hordri/Wemos_ora/README.md

# Wemos_ora
Nixie clock with Wemos d1 mini and integrated switchmode supply
