hordri/Wemos_ora/PCB/wemos_ora/wemos_ora.brd

## EAGLE design PCB/wemos_ora/wemos_ora.brd (2019-09-20)

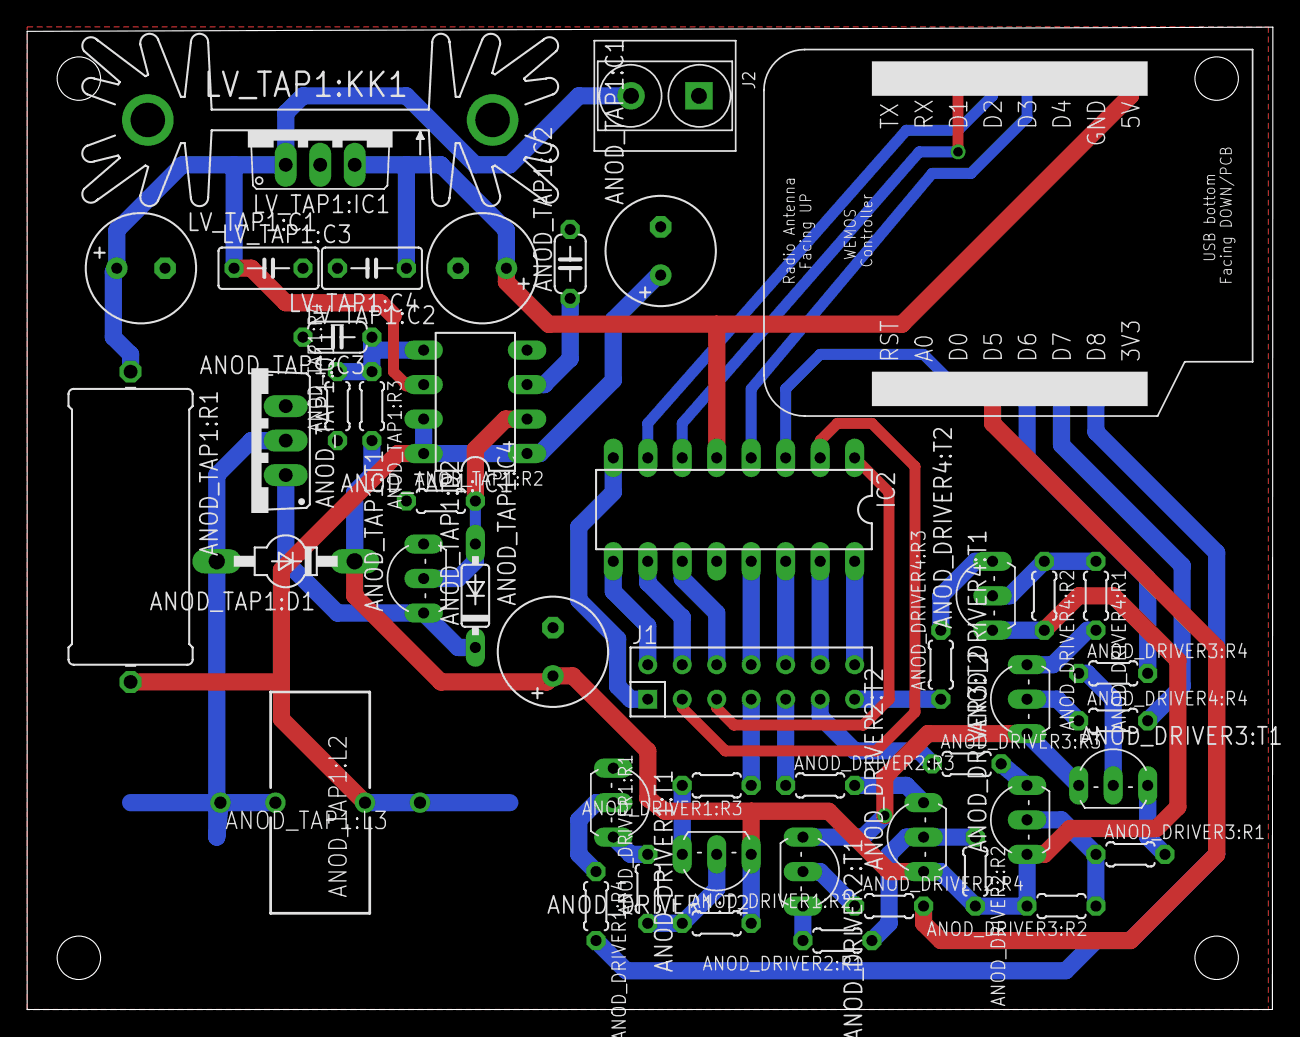
[picture p1: board wemos_ora.brd from above]

Board: 2 copper layers, 91.8 x 72.4 mm, 50 parts (1 on the bottom side), 48 nets.

Parts:
ANOD_DRIVER1:R1, ANOD_DRIVER2:R1, ANOD_DRIVER3:R1, ANOD_DRIVER4:R1: 470k; 0204/5
ANOD_DRIVER1:R2, ANOD_DRIVER2:R2, ANOD_DRIVER3:R2, ANOD_DRIVER4:R2: 100k; 0204/5
ANOD_DRIVER1:R3, ANOD_DRIVER2:R3, ANOD_DRIVER3:R3, ANOD_DRIVER4:R3: 15k; 0204/5
ANOD_DRIVER1:R4, ANOD_DRIVER2:R4, ANOD_DRIVER3:R4, ANOD_DRIVER4:R4: 22k; 0204/5
ANOD_DRIVER1:T1, ANOD_DRIVER2:T1, ANOD_DRIVER3:T1, ANOD_DRIVER4:T1: MPSA42; TO92-EBC
ANOD_DRIVER1:T2, ANOD_DRIVER2:T2, ANOD_DRIVER3:T2, ANOD_DRIVER4:T2: MPSA92; TO92-EBC
ANOD_TAP1:C1: 220u; E3,5-8
ANOD_TAP1:C2: 2n2; C050-024X044
ANOD_TAP1:C3: 10n; C050-024X044
ANOD_TAP1:C4: 2u2; E3,5-8
ANOD_TAP1:D1: BYV27; SOD57-10
ANOD_TAP1:D2: 1N4148DO35-7; DO35-7
ANOD_TAP1:IC1: MC34063AP; DIL08
ANOD_TAP1:L1: PM2120
ANOD_TAP1:L2: TJ3-U1
ANOD_TAP1:L3: TJ3-U2
ANOD_TAP1:Q1: IRF740; TO220BV
ANOD_TAP1:R1: 0R47; 0922/22
ANOD_TAP1:R2: 1k; 0204/5
ANOD_TAP1:R3: 470k; 0204/5
ANOD_TAP1:R4: 3k3; 0204/5
ANOD_TAP1:T1: MPSA92; TO92-EBC
IC2: 74141N; DIL16
J1: CON_HEADER_2X07-PTH; M2X7
J2: 2p-5.08; H2-5.0-10.5X8.0MM
LV_TAP1:C1, LV_TAP1:C2: 470u; E3,5-8
LV_TAP1:C3, LV_TAP1:C4: 100n; C050-030X075
LV_TAP1:IC1: 7805TV; TO220V
LV_TAP1:KK1: SK104-PAD
U$1: WEMOS

Connections:
+5V: IC2.5, LV_TAP1:C2.+, LV_TAP1:C4.1, LV_TAP1:IC1.3, U$1.5V
+9V: ANOD_TAP1:IC1.6, ANOD_TAP1:R1.1, J2.2, LV_TAP1:C1.+, LV_TAP1:C3.1, LV_TAP1:IC1.1
+24V: ANOD_DRIVER1:R2.2, ANOD_DRIVER1:T2.E, ANOD_DRIVER2:R2.2, ANOD_DRIVER2:T2.E, ANOD_DRIVER3:R2.2, ANOD_DRIVER3:T2.E, ANOD_DRIVER4:R2.2, ANOD_DRIVER4:T2.E, ANOD_TAP1:C4.+, ANOD_TAP1:D1.C, ANOD_TAP1:R3.2
ANOD_DRIVER1:N$1: ANOD_DRIVER1:R3.2, ANOD_DRIVER1:T2.C
ANOD_DRIVER1:N$2: ANOD_DRIVER1:R1.1, ANOD_DRIVER1:R2.1, ANOD_DRIVER1:T2.B
ANOD_DRIVER1:N$3: ANOD_DRIVER1:R1.2, ANOD_DRIVER1:T1.C
ANOD_DRIVER1:N$4: ANOD_DRIVER1:R4.1, ANOD_DRIVER1:T1.B
ANOD_DRIVER2:N$1: ANOD_DRIVER2:R3.2, ANOD_DRIVER2:T2.C
ANOD_DRIVER2:N$2: ANOD_DRIVER2:R1.1, ANOD_DRIVER2:R2.1, ANOD_DRIVER2:T2.B
ANOD_DRIVER2:N$3: ANOD_DRIVER2:R1.2, ANOD_DRIVER2:T1.C
ANOD_DRIVER2:N$4: ANOD_DRIVER2:R4.1, ANOD_DRIVER2:T1.B
ANOD_DRIVER3:N$1: ANOD_DRIVER3:R3.2, ANOD_DRIVER3:T2.C
ANOD_DRIVER3:N$2: ANOD_DRIVER3:R1.1, ANOD_DRIVER3:R2.1, ANOD_DRIVER3:T2.B
ANOD_DRIVER3:N$3: ANOD_DRIVER3:R1.2, ANOD_DRIVER3:T1.C
ANOD_DRIVER3:N$4: ANOD_DRIVER3:R4.1, ANOD_DRIVER3:T1.B
ANOD_DRIVER4:N$1: ANOD_DRIVER4:R3.2, ANOD_DRIVER4:T2.C
ANOD_DRIVER4:N$2: ANOD_DRIVER4:R1.1, ANOD_DRIVER4:R2.1, ANOD_DRIVER4:T2.B
ANOD_DRIVER4:N$3: ANOD_DRIVER4:R1.2, ANOD_DRIVER4:T1.C
ANOD_DRIVER4:N$4: ANOD_DRIVER4:R4.1, ANOD_DRIVER4:T1.B
ANOD_TAP1:N$1: ANOD_TAP1:C1.+, ANOD_TAP1:IC1.1, ANOD_TAP1:IC1.7, ANOD_TAP1:IC1.8, ANOD_TAP1:L1.1, ANOD_TAP1:L2.1, ANOD_TAP1:L3.1, ANOD_TAP1:R1.2
ANOD_TAP1:N$3: ANOD_TAP1:D1.A, ANOD_TAP1:L1.2, ANOD_TAP1:L2.2, ANOD_TAP1:L3.2, ANOD_TAP1:Q1.D
ANOD_TAP1:N$4: ANOD_TAP1:D2.A, ANOD_TAP1:IC1.2, ANOD_TAP1:R2.2, ANOD_TAP1:T1.B
ANOD_TAP1:N$5: ANOD_TAP1:D2.C, ANOD_TAP1:Q1.G, ANOD_TAP1:T1.E
ANOD_TAP1:N$8: ANOD_TAP1:C2.1, ANOD_TAP1:IC1.3
ANOD_TAP1:N$14: ANOD_TAP1:C3.1, ANOD_TAP1:IC1.5, ANOD_TAP1:R3.1, ANOD_TAP1:R4.2
GND: ANOD_DRIVER1:T1.E, ANOD_DRIVER2:T1.E, ANOD_DRIVER3:T1.E, ANOD_DRIVER4:T1.E, ANOD_TAP1:C1.-, ANOD_TAP1:C2.2, ANOD_TAP1:C3.2, ANOD_TAP1:C4.-, ANOD_TAP1:IC1.4, ANOD_TAP1:Q1.S, ANOD_TAP1:R2.1, ANOD_TAP1:R4.1, ANOD_TAP1:T1.C, IC2.12, J2.1, LV_TAP1:C1.-, LV_TAP1:C2.-, LV_TAP1:C3.2, LV_TAP1:C4.2, LV_TAP1:IC1.2, U$1.GND
unnamed: IC2.16, J1.14
unnamed: IC2.15, J1.12
unnamed: IC2.8, J1.1
unnamed: IC2.9, J1.2
unnamed: IC2.13, J1.8
unnamed: IC2.14, J1.10
unnamed: IC2.11, J1.6
unnamed: IC2.10, J1.4
unnamed: IC2.1, J1.5
unnamed: IC2.2, J1.3
unnamed: ANOD_DRIVER1:R3.1, J1.7
unnamed: ANOD_DRIVER2:R3.1, J1.9
unnamed: ANOD_DRIVER3:R3.1, J1.11
unnamed: ANOD_DRIVER4:R3.1, J1.13
unnamed: IC2.3, U$1.D0
unnamed: IC2.6, U$1.D1
unnamed: IC2.7, U$1.D2
unnamed: IC2.4, U$1.D3
unnamed: ANOD_DRIVER1:R4.2, U$1.D8
unnamed: ANOD_DRIVER2:R4.2, U$1.D5
unnamed: ANOD_DRIVER3:R4.2, U$1.D6
unnamed: ANOD_DRIVER4:R4.2, U$1.D7
