hordri/Wemos_ora/PCB/wemos_ora/anod_tap.brd

## EAGLE design PCB/wemos_ora/anod_tap.brd (2019-09-18)

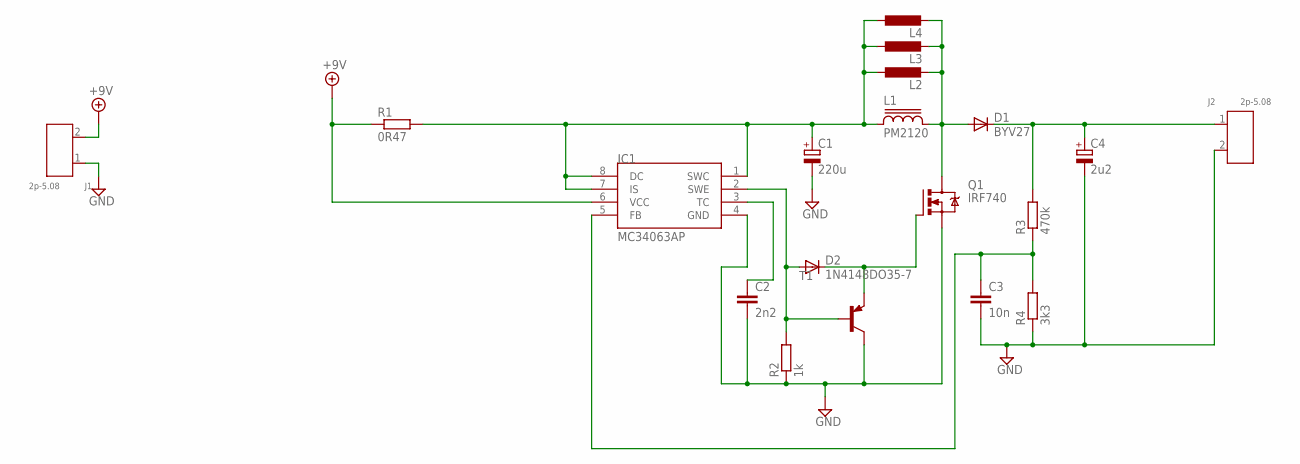
[picture p2: schematic anod_tap.sch]

Parts:
C1: 220u; E3,5-8
C2: 2n2; C050-024X044
C3: 10n; C050-024X044
C4: 2u2; E3,5-8
D1: BYV27; SOD57-10
D2: 1N4148DO35-7; DO35-7
IC1: MC34063AP; DIL08
J1, J2: 2p-5.08; H2-5.0-10.5X8.0MM
L1: PM2120
L2: L-EUTJ3-U1; TJ3-U1
L3: L-EUTJ3-U2; TJ3-U2
L4: L-EUTJ4-U2; TJ4-U2
Q1: IRF740; TO220BV
R1: 0R47; 0922/22
R2: 1k; 0204/5
R3: 470k; 0204/5
R4: 3k3; 0204/5
T1: MPSA92-PNP-TO92-EBC; TO92-EBC

Connections:
+9V: IC1.6 (VCC), J1.2, R1.1
GND: C1.-, C2.2, C3.2, C4.-, IC1.4 (GND), J1.1, J2.2, Q1.S, R2.1, R4.1, T1.C
unnamed: C1.+, IC1.1 (SWC), IC1.7 (IS), IC1.8 (DC), L1.1, L2.1, L3.1, L4.1, R1.2
unnamed: D2.A, IC1.2 (SWE), R2.2, T1.B
unnamed: D2.C, Q1.G, T1.E
unnamed: D1.A, L1.2, L2.2, L3.2, L4.2, Q1.D
unnamed: C2.1, IC1.3 (TC)
unnamed: C4.+, D1.C, J2.1, R3.2
unnamed: C3.1, IC1.5 (FB), R3.1, R4.2

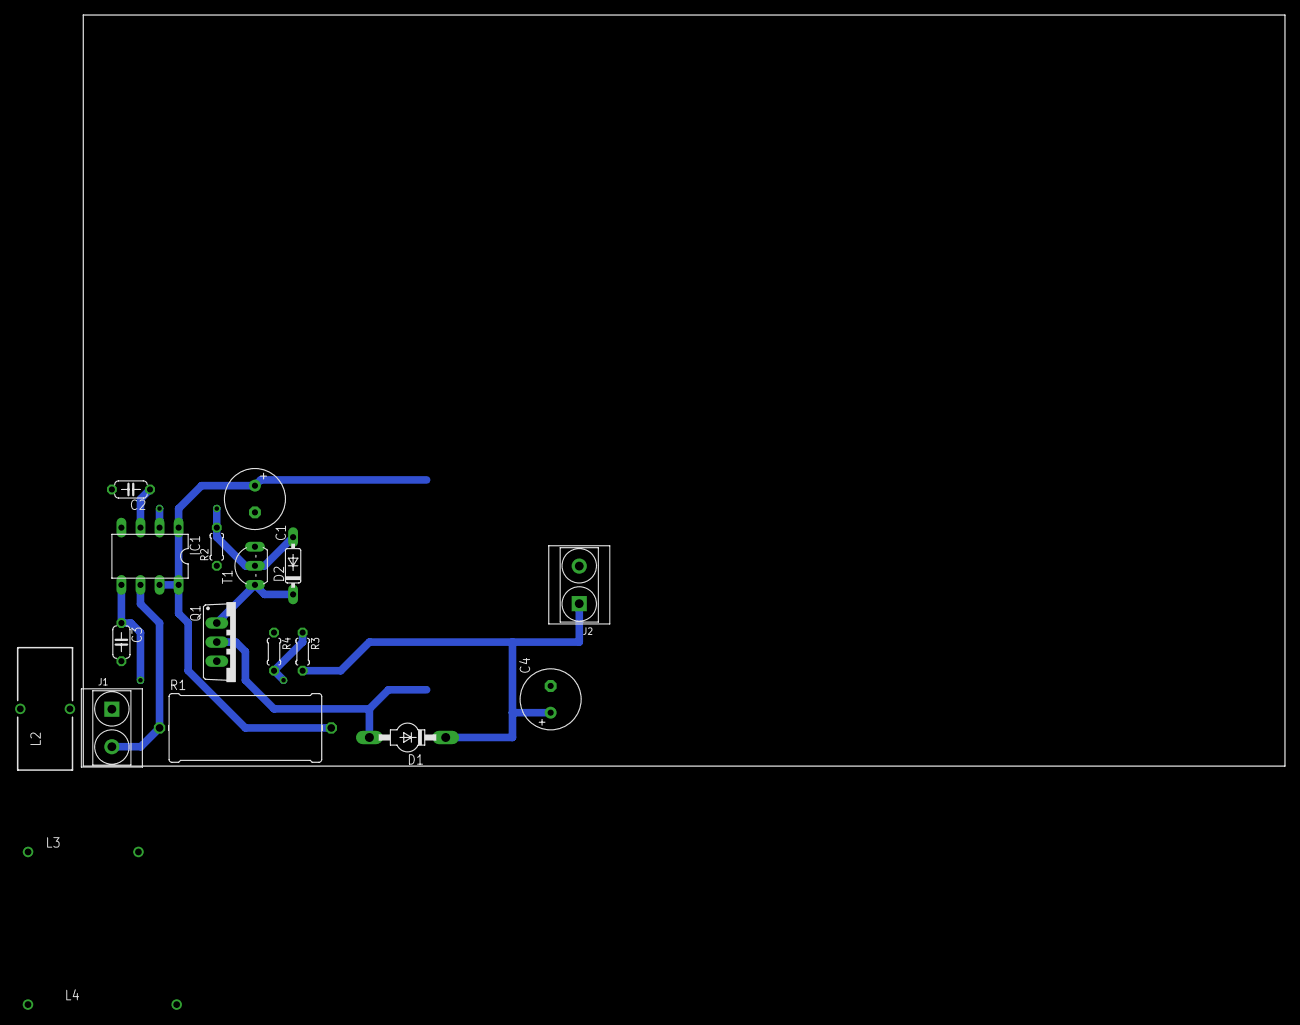
[picture p3: board anod_tap.brd from above]

Board: 2 copper layers, 160.0 x 100.0 mm, 19 parts (1 on the bottom side), 9 nets.
