hordri/Wemos_ora/(threads)

Thread 2 (2019-12-20):

When updating, time display goes mad, single digit stuck

hordri, 2019-12-20:
Time update blocks time displaying in the main loop.

Try interrupt driven multiplexing. Wifi signal strenght related to reply times?
