hordri/Wemos_ora/(commit log)

2019-11-18 Pinout of the doublerow connector
2019-11-27 firmware for 6 tubes with blinking built in LED
2019-12-12 Materials needed for the PCB
